Rafid013/4-Bit-PC/README.md

# 4 Bit PC Simulator for CSE404: Digital System Design Sessional
1. Created a 4 Bit PC Simulator using Proteus.
2. For executing a program, we built a very simple compiler using Java, that takes a assembly code as input and generates the machine code for our simulator as output.

Report: [https://github.com/Rafid013/4-Bit-PC/blob/master/cse-404-report.pdf](https://github.com/Rafid013/4-Bit-PC/blob/master/cse-404-report.pdf)
