Rafid013/4-Bit-PC/Diagrams/Timing Diagram/Images/ADC_address.jpg

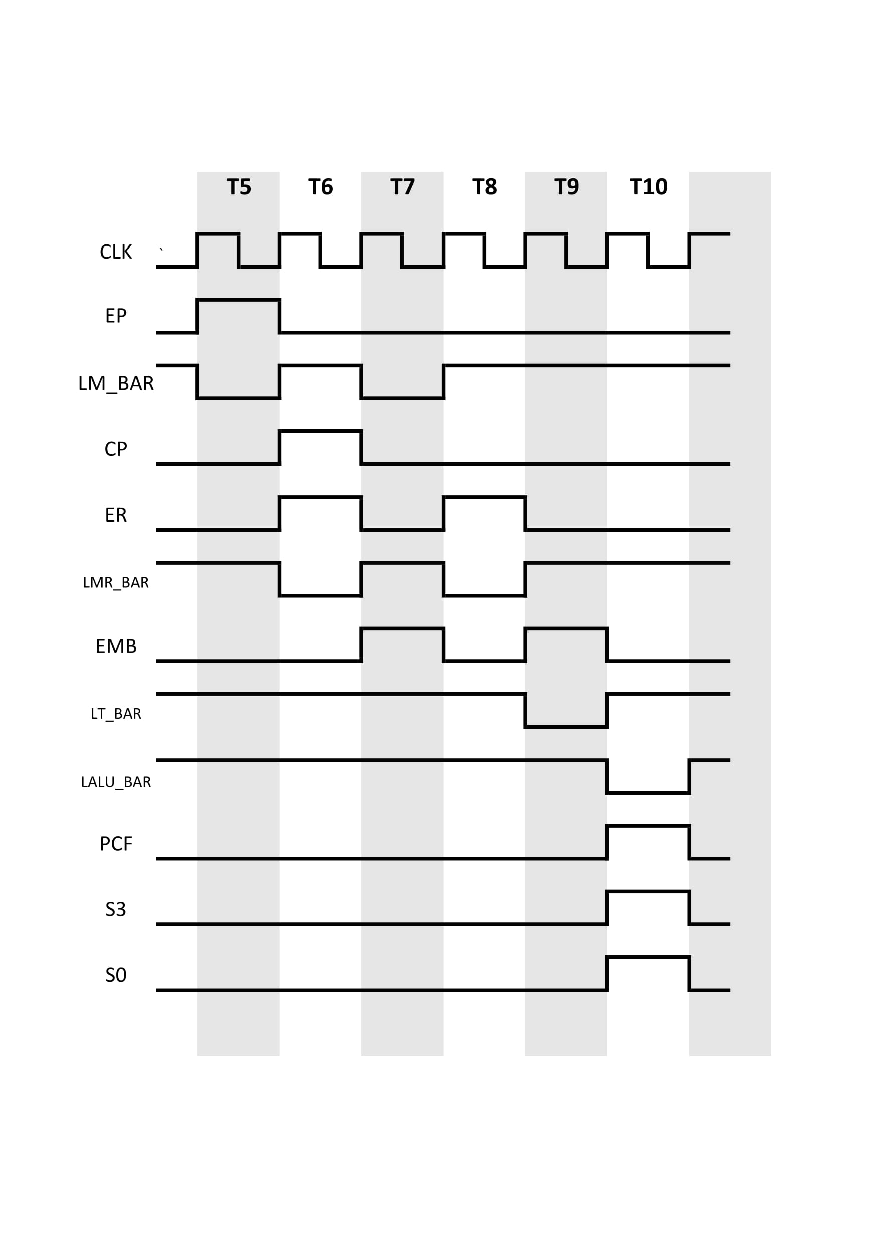
Diagrams/Timing Diagram/Images/ADC_address.jpg
