Rafid013/4-Bit-PC/Diagrams/Timing Diagram/Images/FETCH.jpg

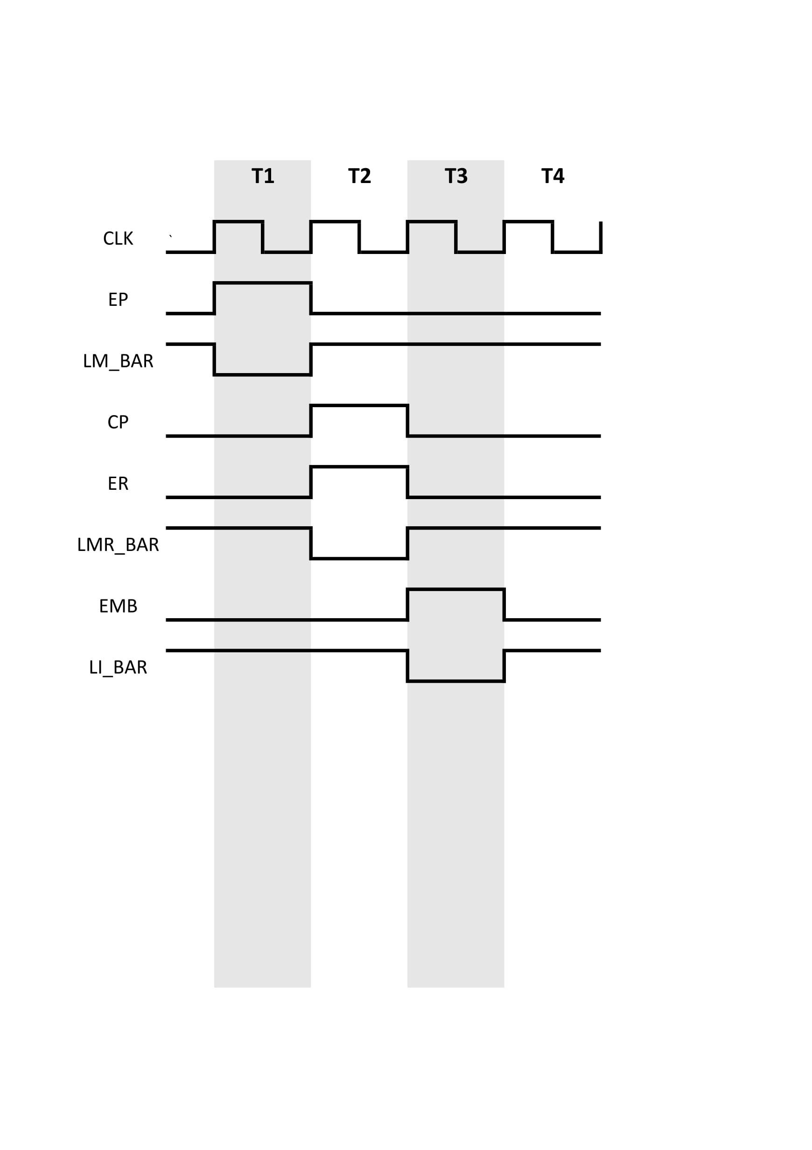
Diagrams/Timing Diagram/Images/FETCH.jpg
