Rafid013/4-Bit-PC/Diagrams/Timing Diagram/Images/OR_immediate.jpg

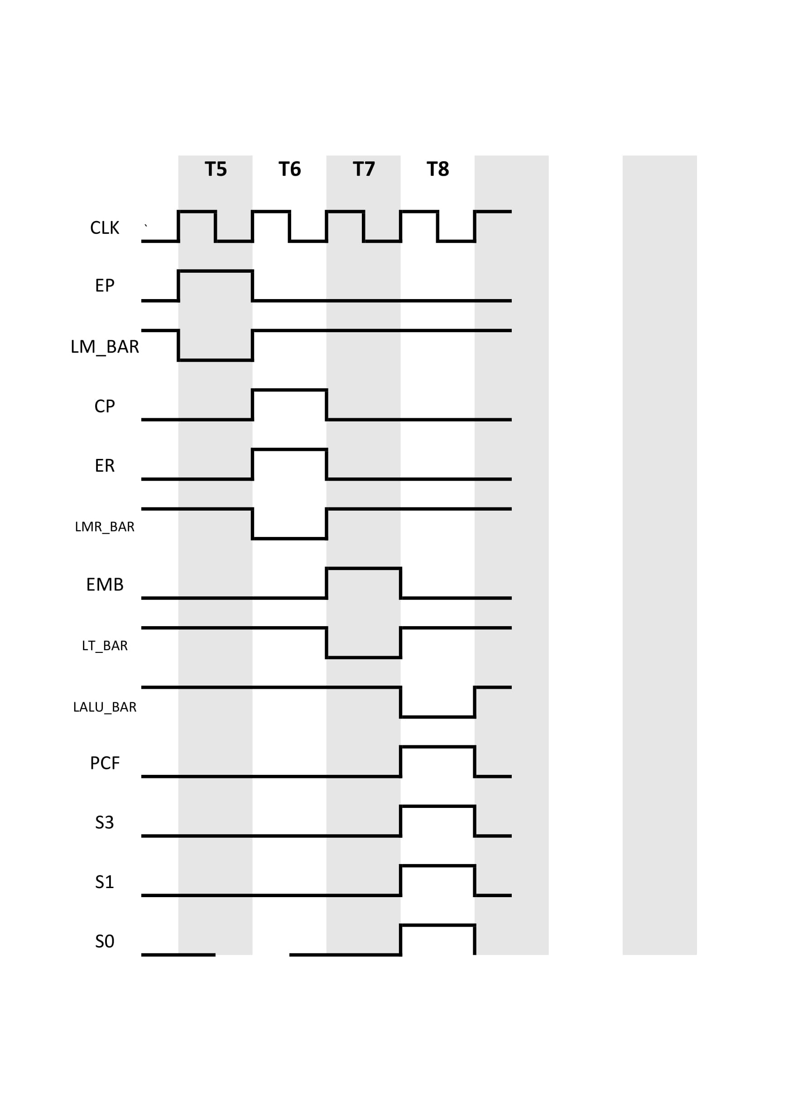
Diagrams/Timing Diagram/Images/OR_immediate.jpg
