Rafid013/4-Bit-PC/Diagrams/Timing Diagram/Images/PUSH.jpg

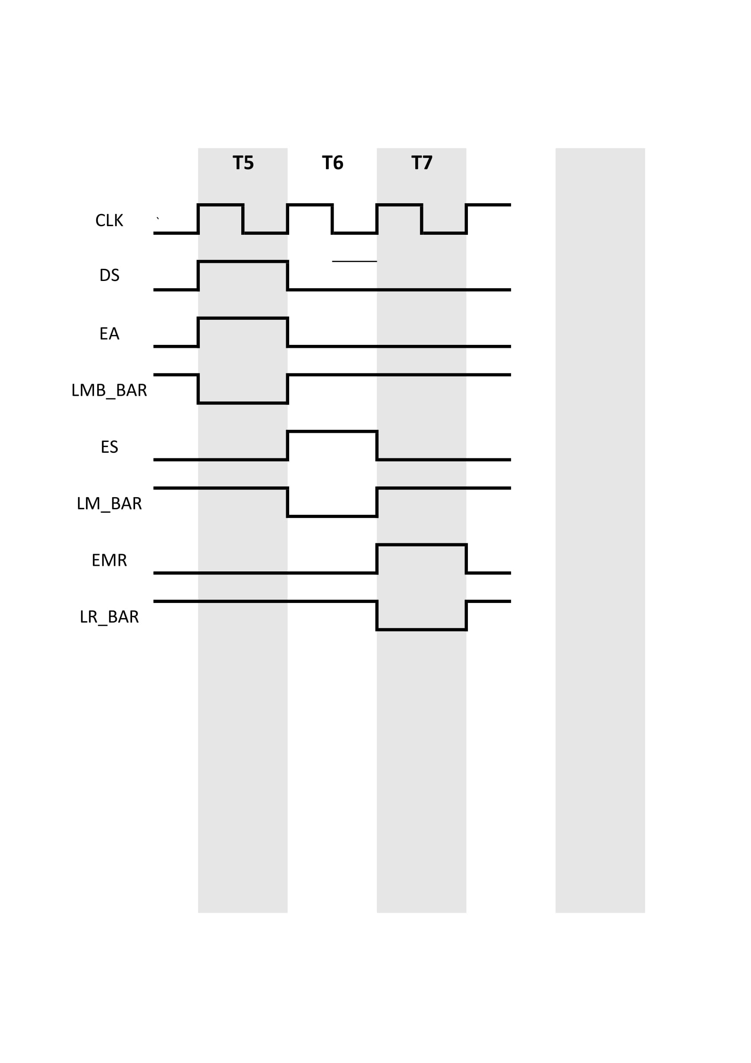
Diagrams/Timing Diagram/Images/PUSH.jpg
