Rafid013/4-Bit-PC/Simulation/4-bit PC Instructions.txt

04 LDA address;
09 STA address;
0E MOV B, Acc;
0F MOV Acc, Immediate;
12 ADC B;
14 ADC address;
1A SBB address;
20 OUT;
21 PUSH;
24 POP;
27 AND B;
29 OR address;
2F OR Immediate;
33 NOT;
34 XCHG;
37 CMP B;
39 TEST B;
3B ROL;
3C RCL;
3E JMP address;
41 JNZ address;
43 CLC;
44 CLS;
45 HLT;
46 NOP;
