Rafid013/4-Bit-PC/Diagrams/Circuit Diagram/MDR.PDF

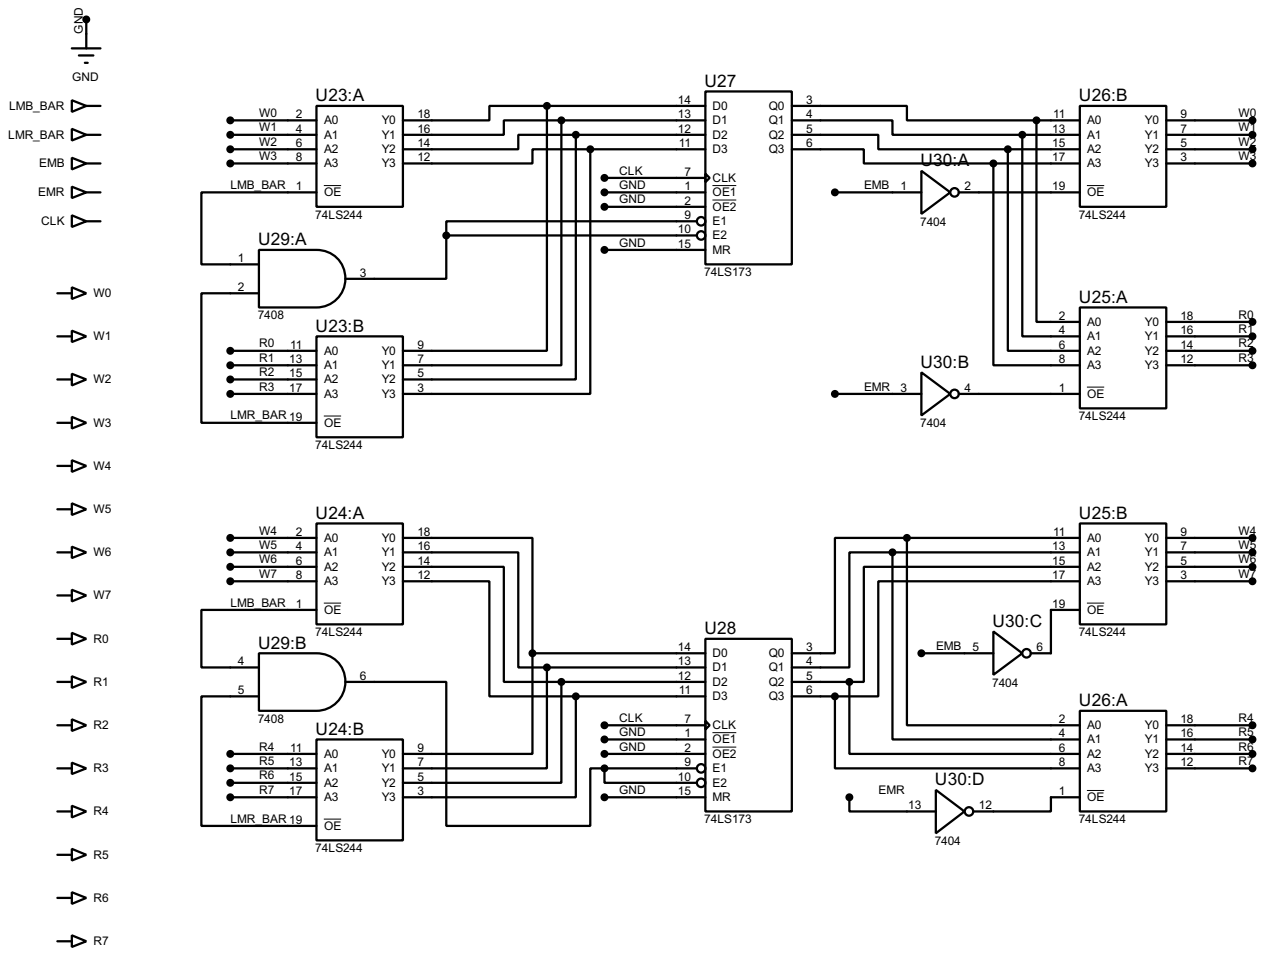
[picture p17: page 1]

GND R0R1R2R3 W4 W5 W6 W7 R4R5R6R7 CLK GND GND GND CLK GND GND GND W0 W1 W2 W3 R0R1R2R3 W4 W5 W6 W7 R4R5R6R7 LMB_BAR LMR_BAR LMB_BAR LMR_BAR EMB W0 W1 W2 W3 EMR EMB EMR LMB_BAR LMR_BAR EMB W0 W1 W2 W3 GNDW4 W5 W6 W7 R0R1R2R3R4R5R6R7 EMR CLK A0 2 A1 4 A2 6 A3 8 OE 1 Y0 18 Y1 16 Y2 14 Y3 12 U23:A 74LS244 A0 11 A1 13 A2 15 A3 17 OE 19 Y0 9 Y1 7 Y2 5 Y3 3 U23:B 74LS244 A0 2 A1 4 A2 6 A3 8 OE 1 Y0 18 Y1 16 Y2 14 Y3 12 U24:A 74LS244 A0 11 A1 13 A2 15 A3 17 OE 19 Y0 9 Y1 7 Y2 5 Y3 3 U24:B 74LS244 A0 2 A1 4 A2 6 A3 8 OE 1 Y0 18 Y1 16 Y2 14 Y3 12 U25:A 74LS244 A0 11 A1 13 A2 15 A3 17 OE 19 Y0 9 Y1 7 Y2 5 Y3 3 U25:B 74LS244 A0 2 A1 4 A2 6 A3 8 OE 1 Y0 18 Y1 16 Y2 14 Y3 12 U26:A 74LS244 D0 14 Q0 3 D1 13 Q1 4 D2 12 Q2 5 D3 11 Q3 6 CLK 7 OE1 1 OE2 2 E1 9 E2 10 MR 15 U27 74LS173 D0 14 Q0 3 D1 13 Q1 4 D2 12 Q2 5 D3 11 Q3 6 CLK 7 OE1 1 OE2 2 E1 9 E2 10 MR 15 U28 74LS173 12 3 U29:A 7408 45 6 U29:B 7408 1 2 U30:A 7404 A0 11 A1 13 A2 15 A3 17 OE 19 Y0 9 Y1 7 Y2 5 Y3 3 U26:B 74LS244 3 4 U30:B 7404 5 6 U30:C 7404 13 12 U30:D 7404
