Rafid013/4-Bit-PC/Diagrams/Circuit Diagram/All Circuit DIagrams.PDF

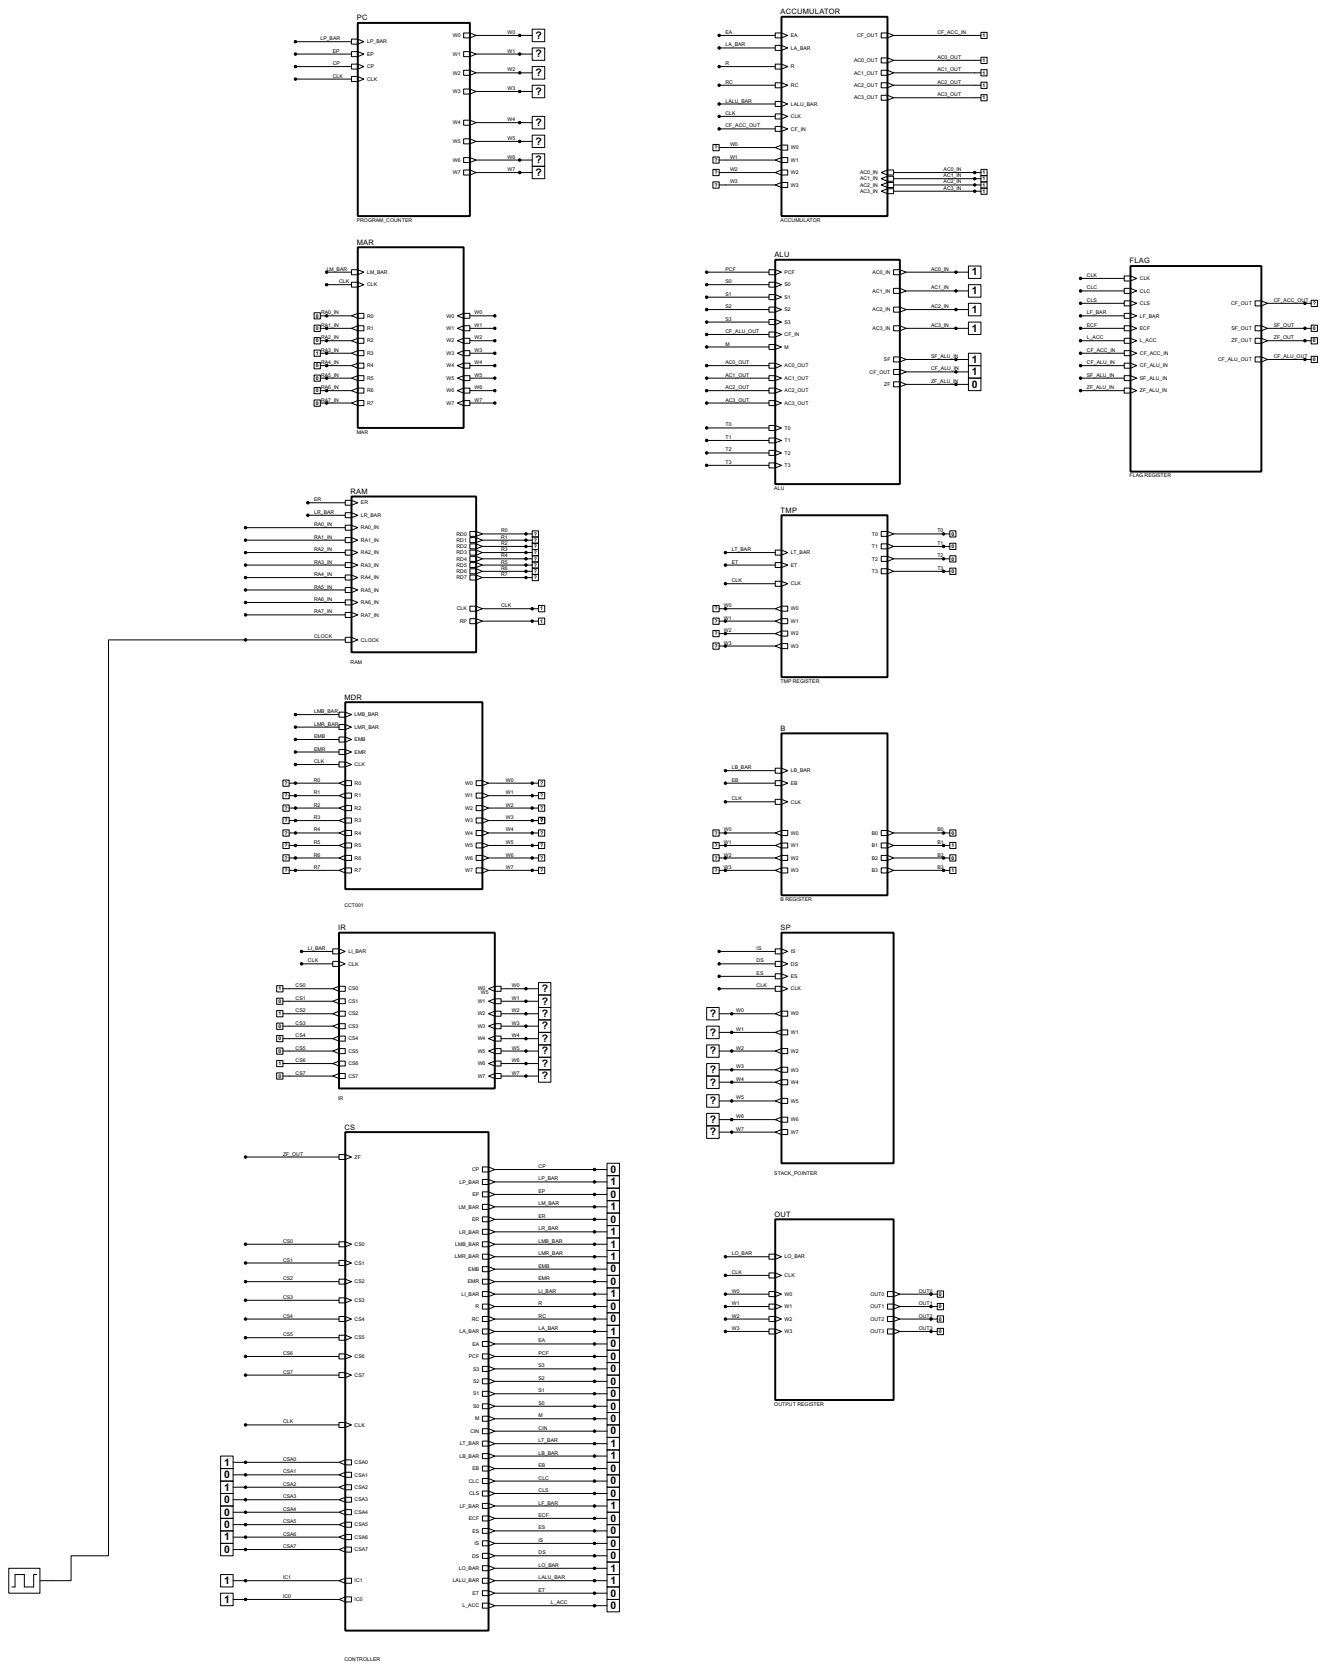
[picture p18: page 1]

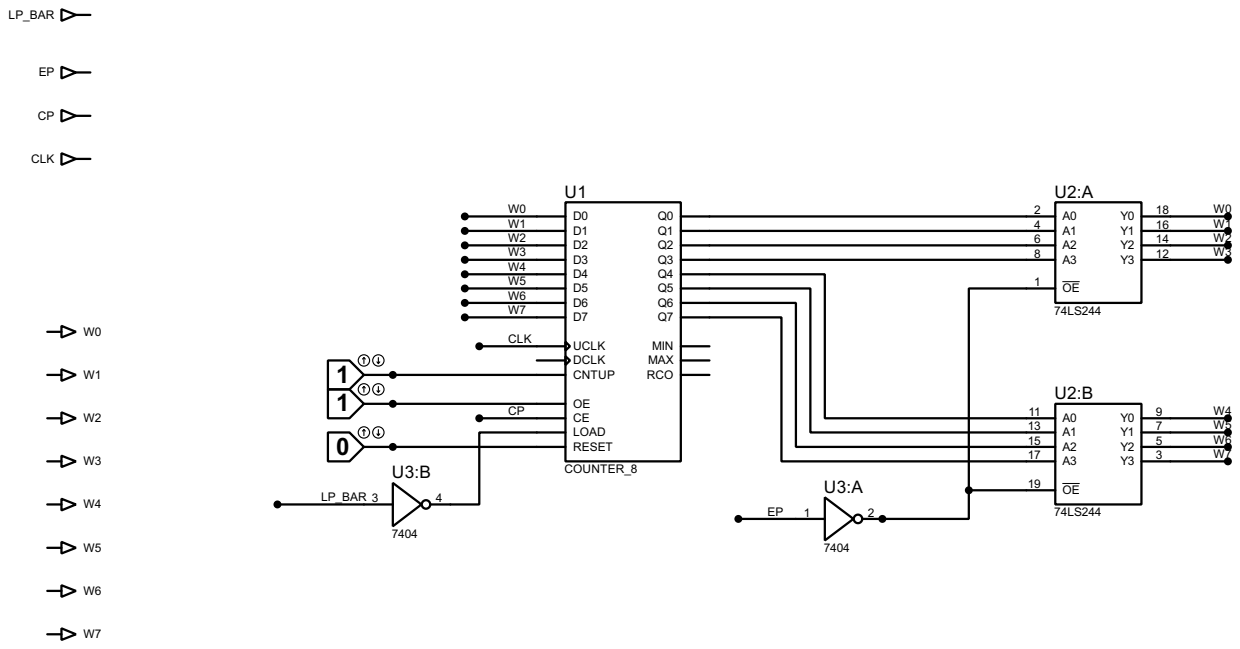
[picture p19: page 2]

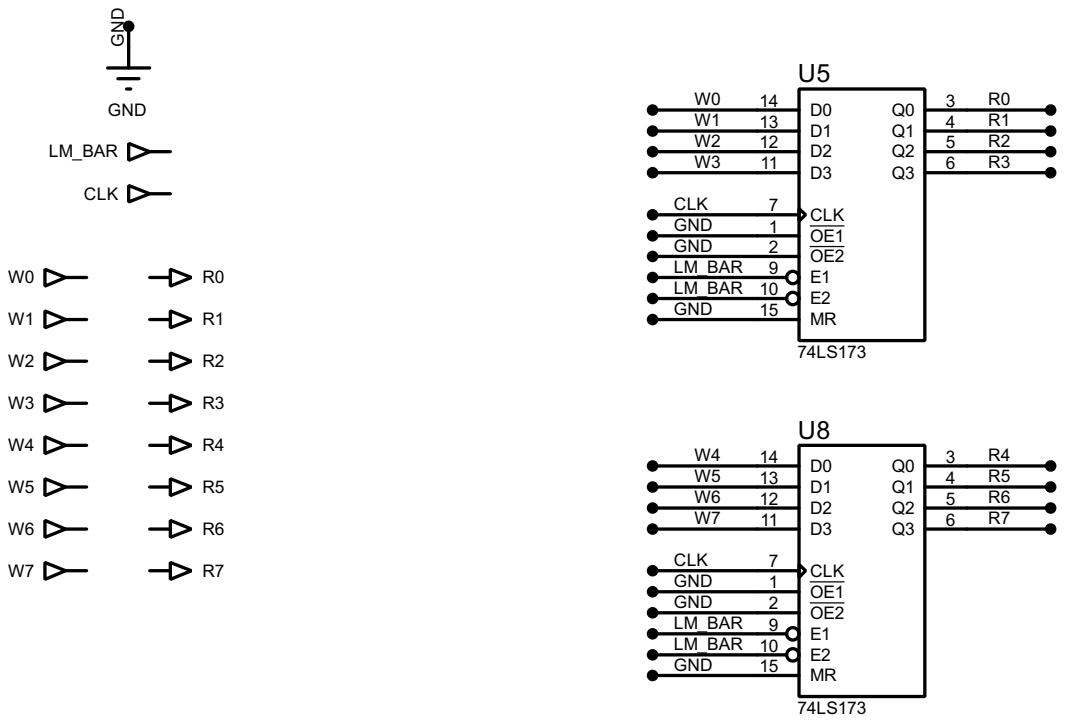
[picture p20: page 3]

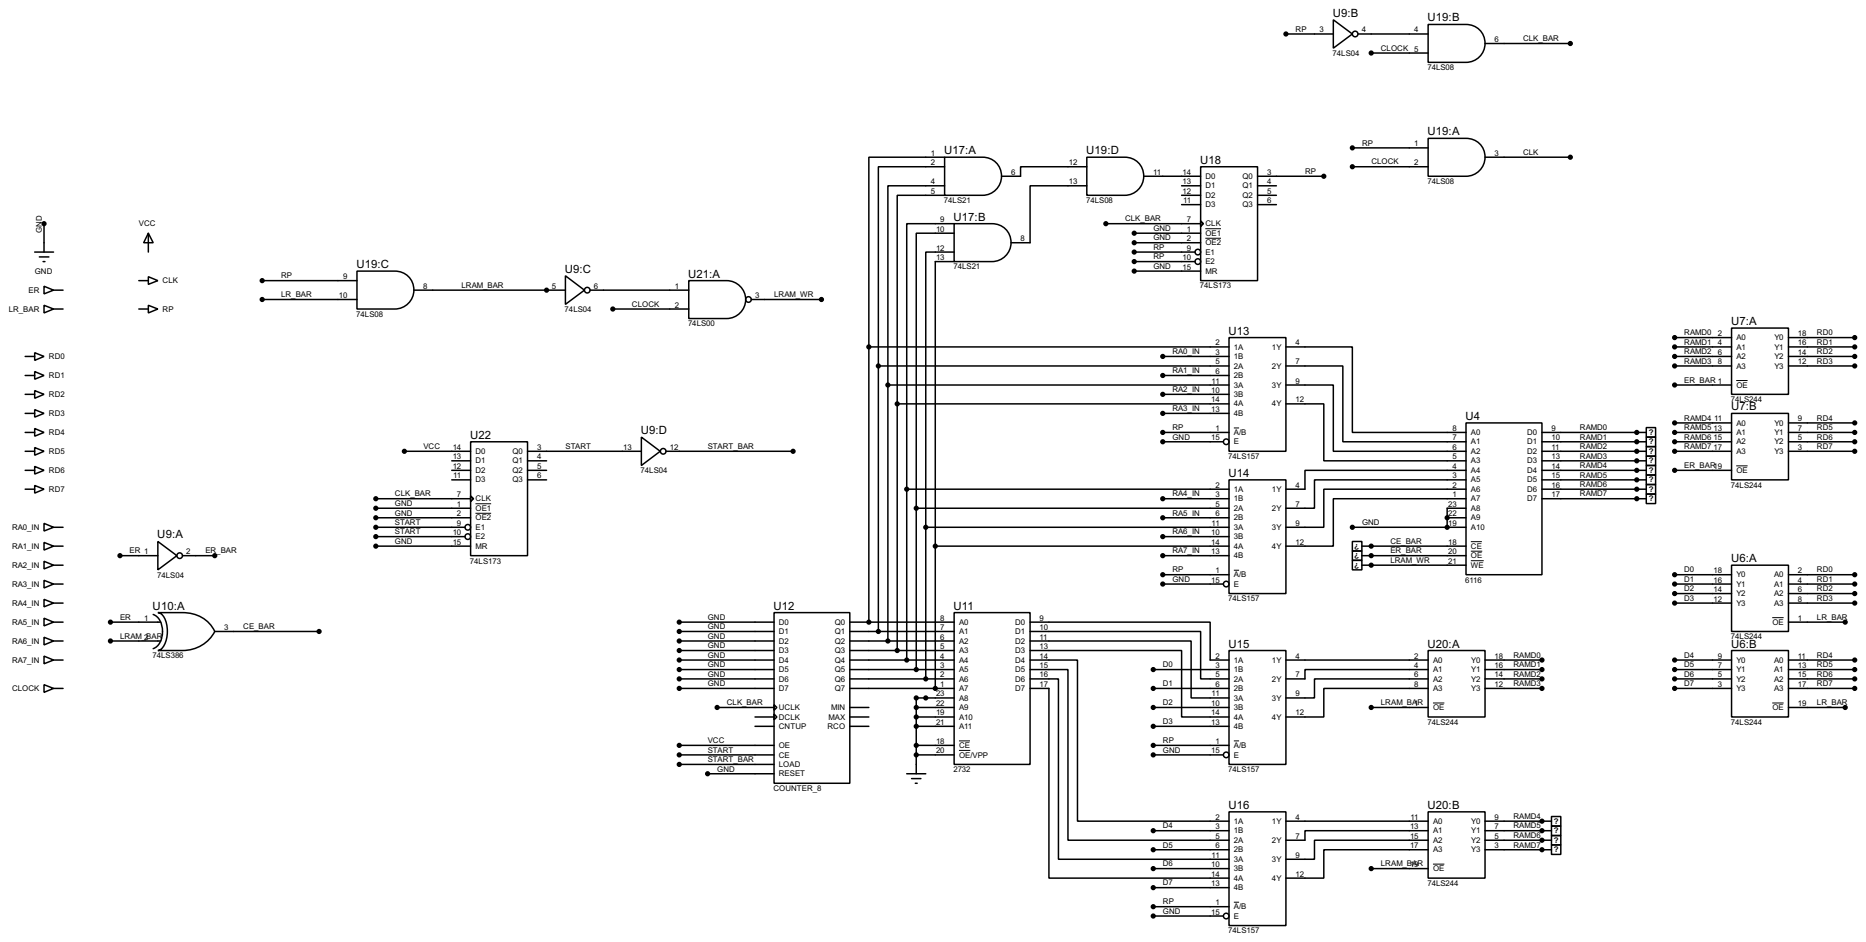
[picture p21: page 4]

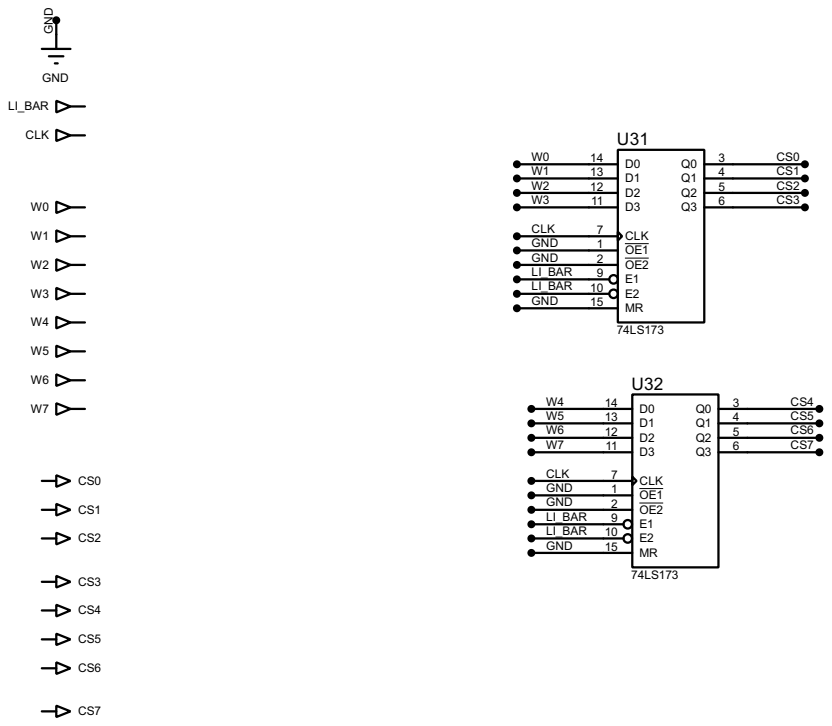
[picture p22: page 5]

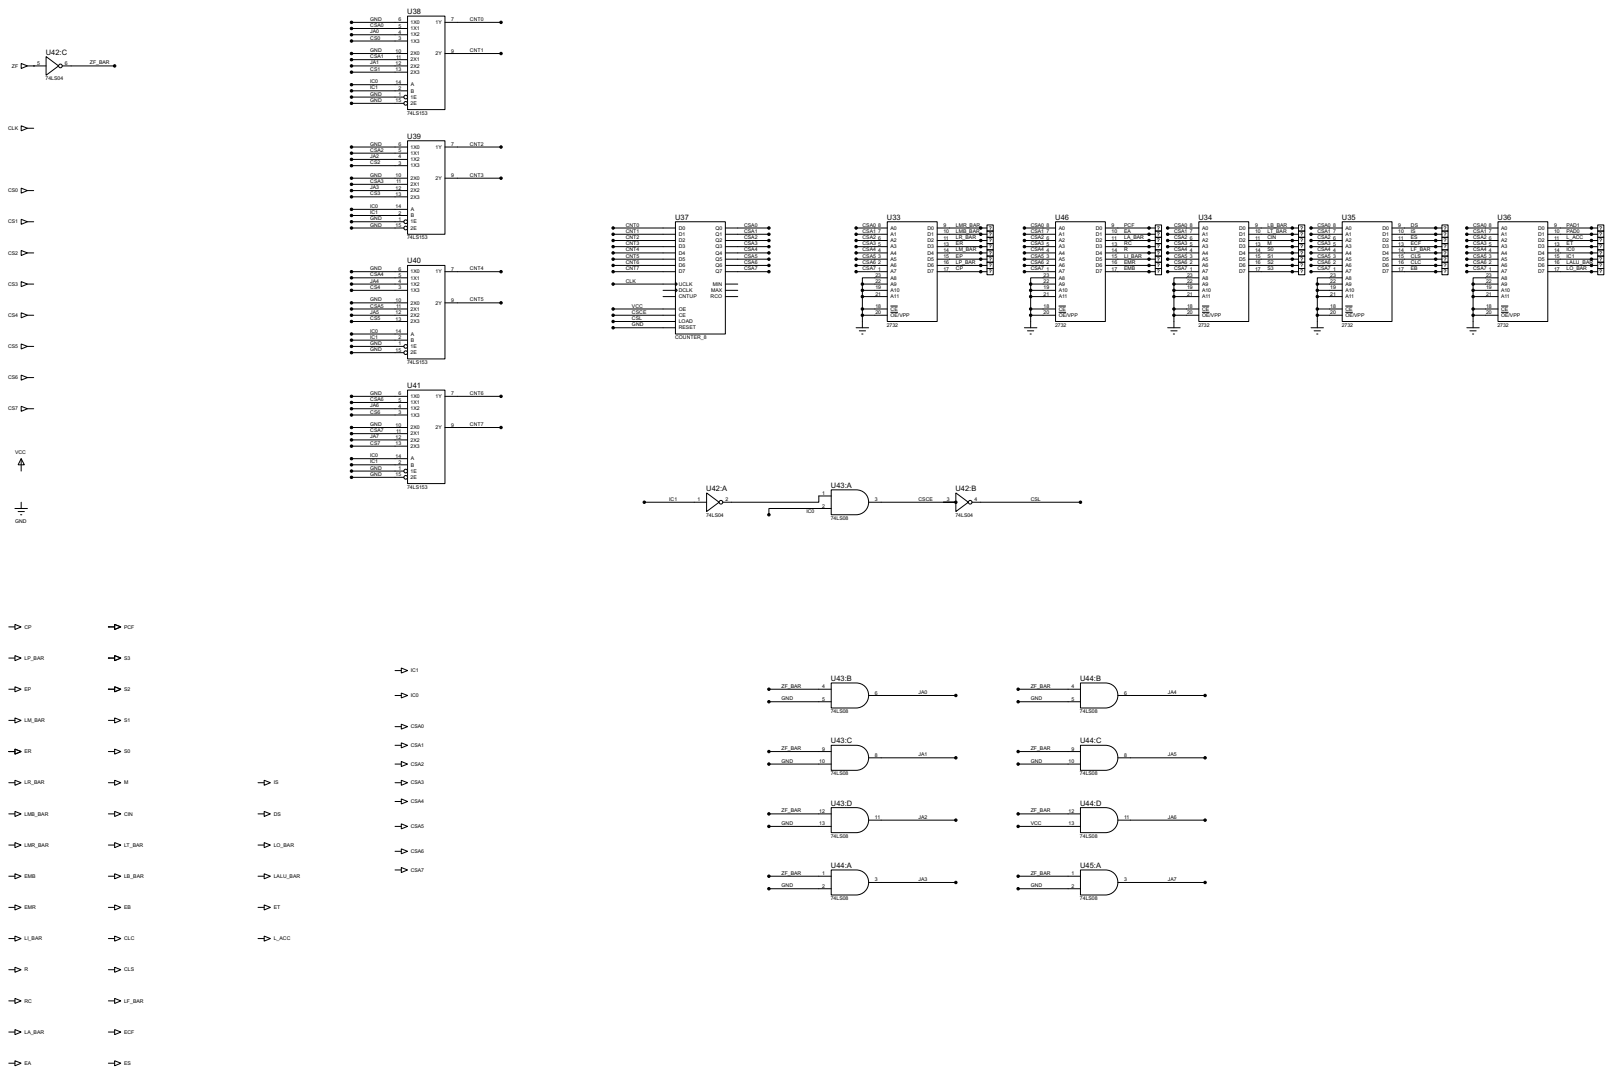
[picture p23: page 6]


GND D0D1 GND GND S1S2 D2D3 GND GND S1S2 LALU_BAR LALU LA_BAR LA RRC R + RC R + RC R + RC LA S2S1 LALU CLK GND GND GND GND GND Q0 AC0_IN W0 IQ1 AC1_IN W1 Q0 Q2 AC2_IN W2 Q1 Q3 AC3_IN W3 Q2 Q3 RCCF_IN I R Q3 RC AC0_OUT AC1_OUT AC2_OUT AC3_OUT GND W0 W1 W2 W3 EA Q0 Q1 Q2 Q3 CLK CF_OUT GND RCCF_IN LALU_BAR LA_BAR CLK GND EARRC W0 W1 W2 W3 AC0_OUT AC1_OUT AC2_OUT AC3_OUT CF_OUT D0 14 Q0 3 D1 13 Q1 4 D2 12 Q2 5 D3 11 Q3 6 CLK 7 OE1 1 OE2 2 E1 9 E2 10 MR 15 U47 74LS173 1X0 6 1Y 7 1X1 5 1X2 4 1X3 3 2X0 10 2Y 9 2X1 11 2X2 12 2X3 13 A 14 B 2 1E 1 2E 15 U48 74LS153 1X0 6 1Y 7 1X1 5 1X2 4 1X3 3 2X0 10 2Y 9 2X1 11 2X2 12 2X3 13 A 14 B 2 1E 1 2E 15 U49 74LS153 1 2 U50:A 74LS04 3 4 U50:B 74LS04 12 3 U51:A 74LS32 45 6 U51:B 74LS32 910 8 U51:C 74LS32 12 3 U52:A 74LS08 45 6 U52:B 74LS08 1213 11 U51:D 74LS32 910 8 U52:C 74LS08 12 3 U53:A 74LS32 A0 2 A1 4 A2 6 A3 8 OE 1 Y0 18 Y1 16 Y2 14 Y3 12 U54:A 74LS244 A0 11 A1 13 A2 15 A3 17 OE 19 Y0 9 Y1 7 Y2 5 Y3 3 U54:B 74LS244 5 6 U50:C 74LS04 D0 14 Q0 3 D1 13 Q1 4 D2 12 Q2 5 D3 11 Q3 6 CLK 7 OE1 1 OE2 2 E1 9 E2 10 MR 15 U55 74LS173 13 12 U50:D 74LS04 1213 11 U52:D 74LS08 AC0_IN AC1_IN AC2_IN AC3_IN CF_IN

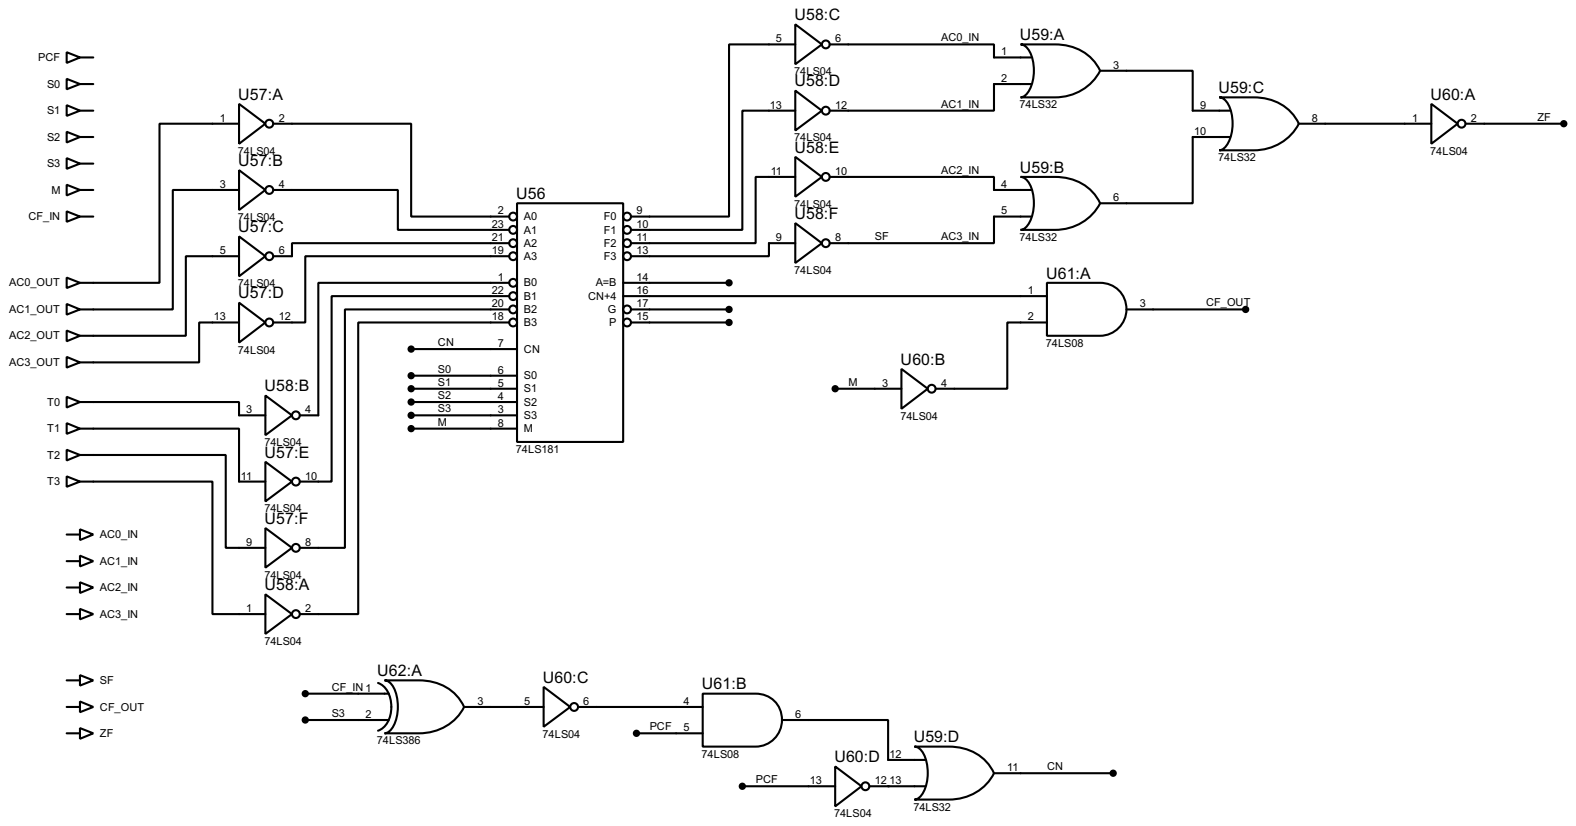
[picture p24: page 8]

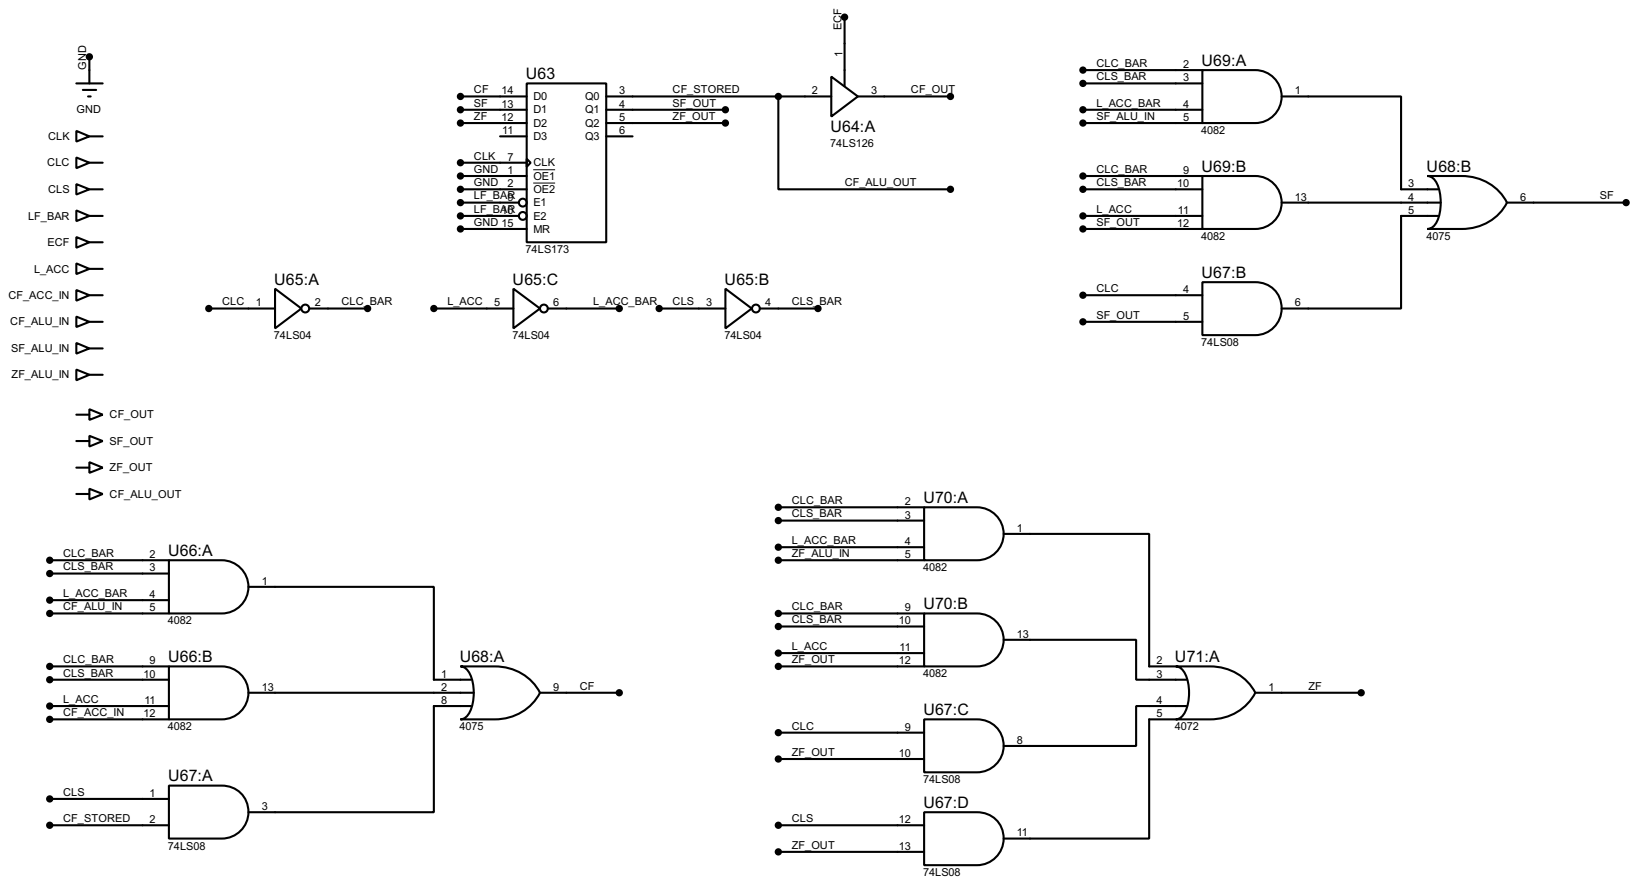
[picture p25: page 9]

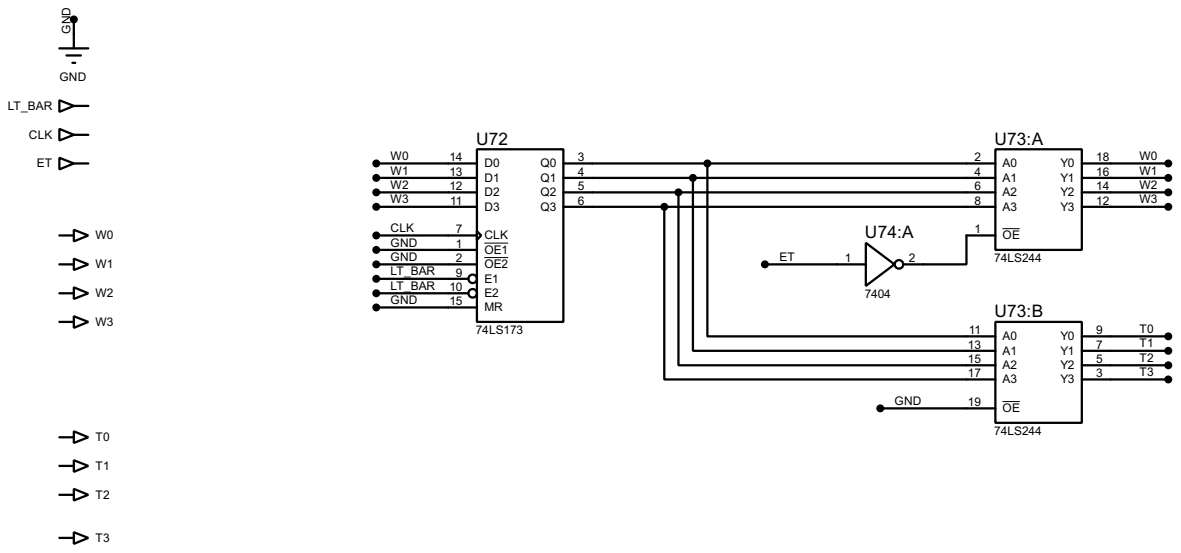
[picture p26: page 10]

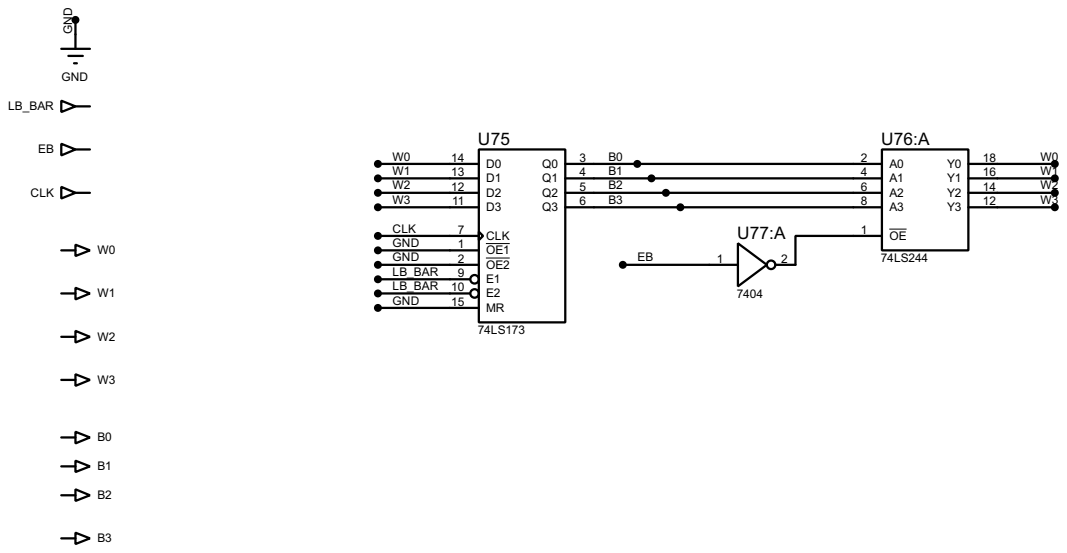
[picture p27: page 11]

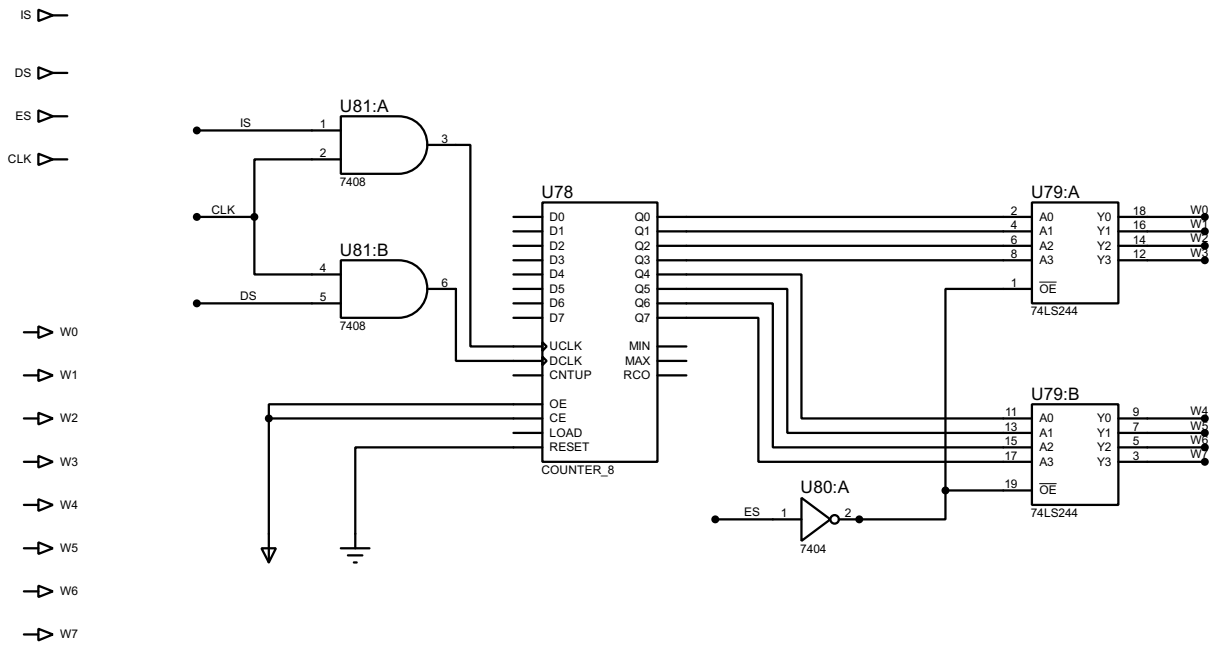
[picture p28: page 12]

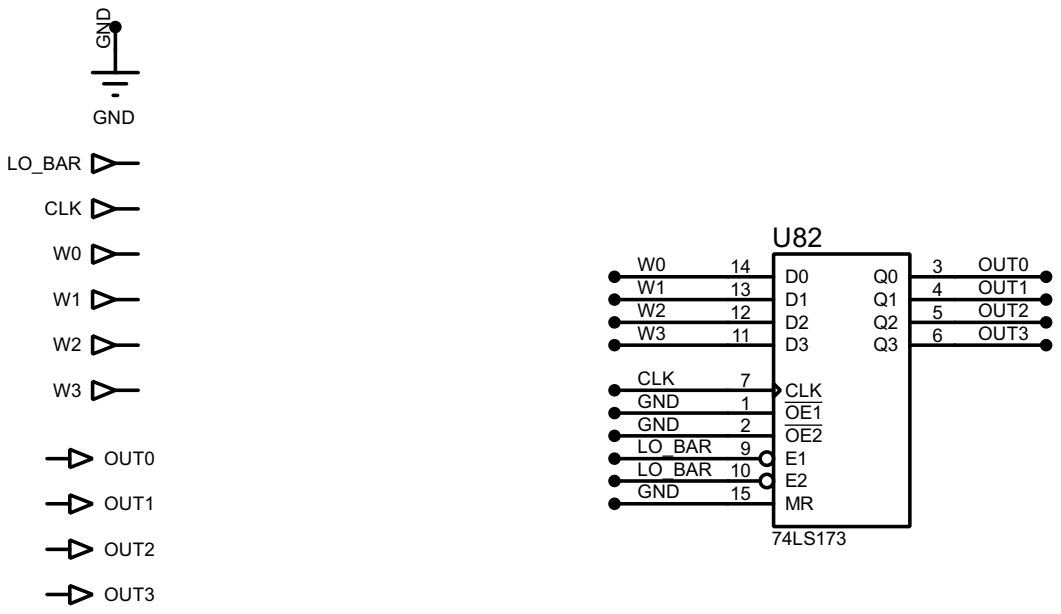
[picture p29: page 13]


GND R0R1R2R3 W4 W5 W6 W7 R4R5R6R7 CLK GND GND GND CLK GND GND GND W0 W1 W2 W3 R0R1R2R3 W4 W5 W6 W7 R4R5R6R7 LMB_BAR LMR_BAR LMB_BAR LMR_BAR EMB W0 W1 W2 W3 EMR EMB EMR LMB_BAR LMR_BAR EMB W0 W1 W2 W3 GNDW4 W5 W6 W7 R0R1R2R3R4R5R6R7 EMR CLK A0 2 A1 4 A2 6 A3 8 OE 1 Y0 18 Y1 16 Y2 14 Y3 12 U23:A 74LS244 A0 11 A1 13 A2 15 A3 17 OE 19 Y0 9 Y1 7 Y2 5 Y3 3 U23:B 74LS244 A0 2 A1 4 A2 6 A3 8 OE 1 Y0 18 Y1 16 Y2 14 Y3 12 U24:A 74LS244 A0 11 A1 13 A2 15 A3 17 OE 19 Y0 9 Y1 7 Y2 5 Y3 3 U24:B 74LS244 A0 2 A1 4 A2 6 A3 8 OE 1 Y0 18 Y1 16 Y2 14 Y3 12 U25:A 74LS244 A0 11 A1 13 A2 15 A3 17 OE 19 Y0 9 Y1 7 Y2 5 Y3 3 U25:B 74LS244 A0 2 A1 4 A2 6 A3 8 OE 1 Y0 18 Y1 16 Y2 14 Y3 12 U26:A 74LS244 D0 14 Q0 3 D1 13 Q1 4 D2 12 Q2 5 D3 11 Q3 6 CLK 7 OE1 1 OE2 2 E1 9 E2 10 MR 15 U27 74LS173 D0 14 Q0 3 D1 13 Q1 4 D2 12 Q2 5 D3 11 Q3 6 CLK 7 OE1 1 OE2 2 E1 9 E2 10 MR 15 U28 74LS173 12 3 U29:A 7408 45 6 U29:B 7408 1 2 U30:A 7404 A0 11 A1 13 A2 15 A3 17 OE 19 Y0 9 Y1 7 Y2 5 Y3 3 U26:B 74LS244 3 4 U30:B 7404 5 6 U30:C 7404 13 12 U30:D 7404
