Rafid013/4-Bit-PC/Simulation/Final.PDF

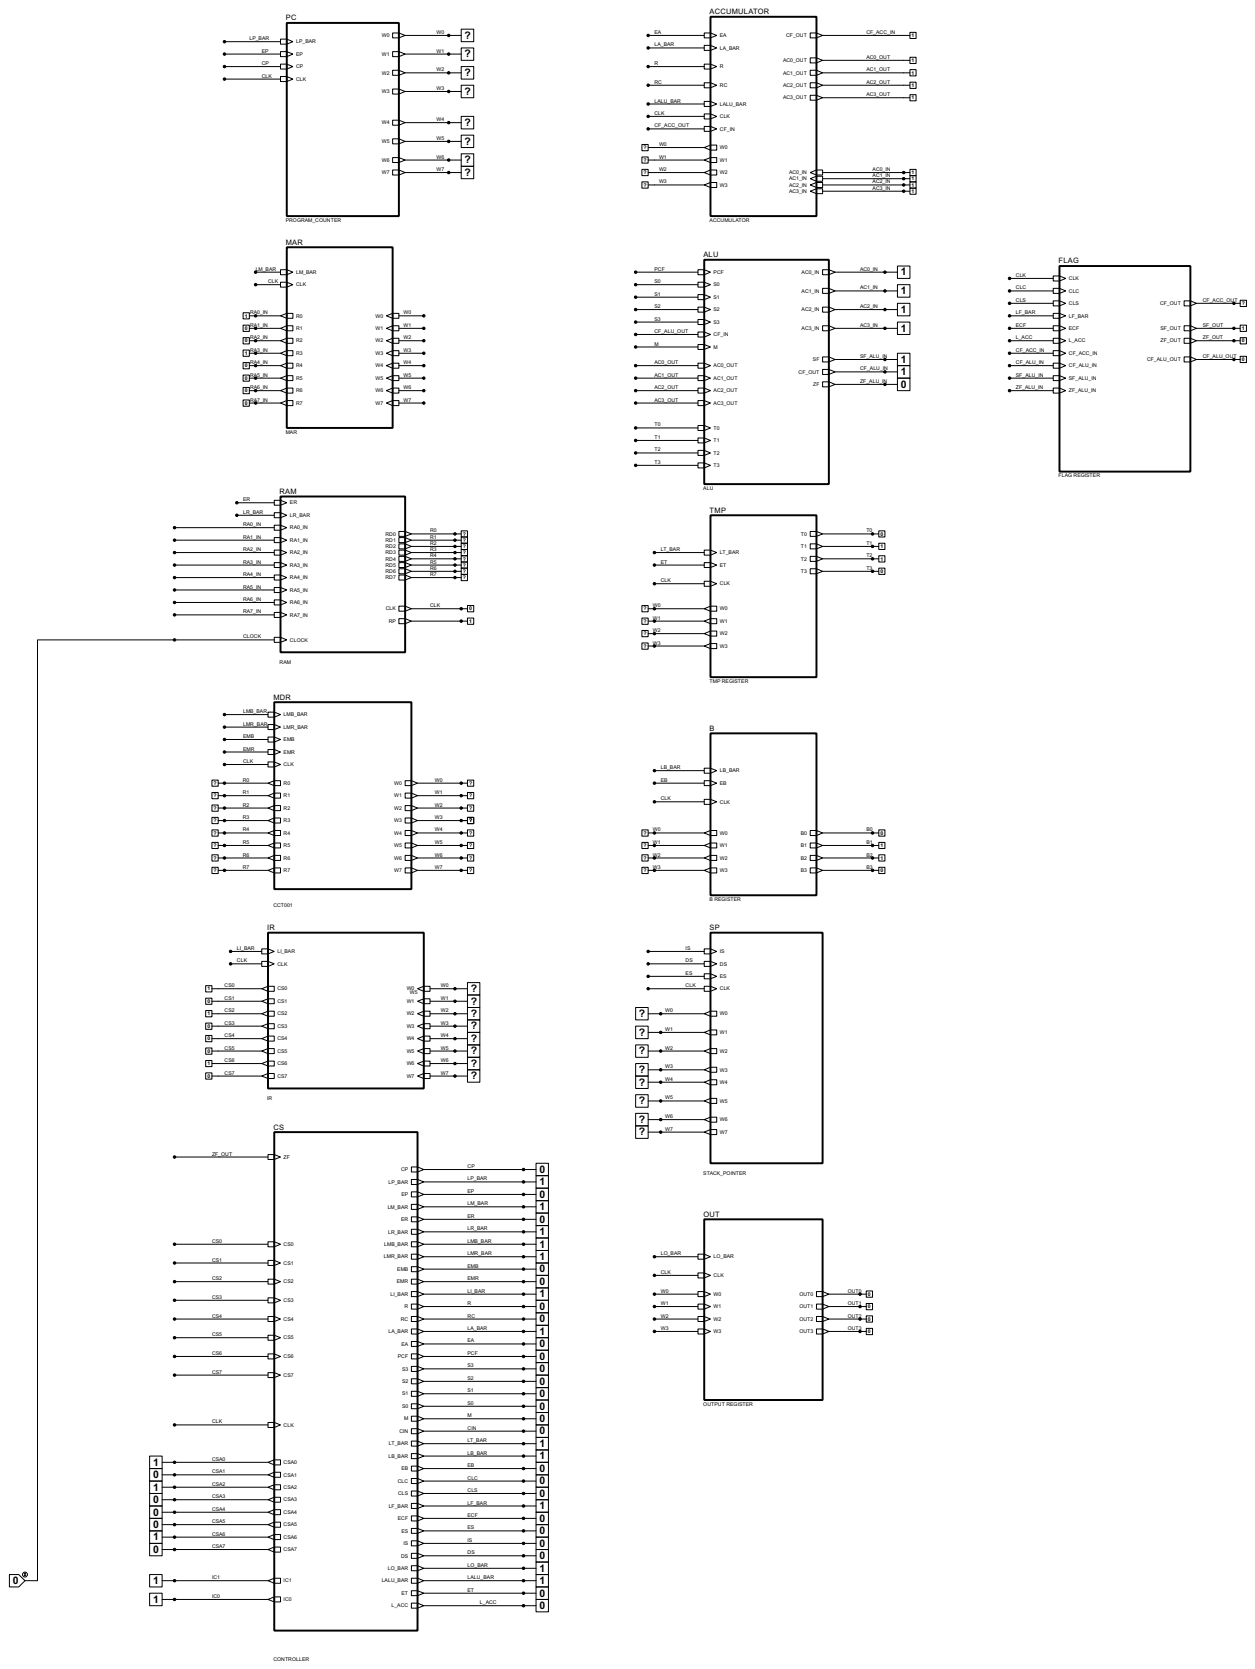
[picture p30: page 1]
