Rafid013/4-Bit-PC/Diagrams/Block Diagram/Block_Diagram.pdf

PC

8 | ACC

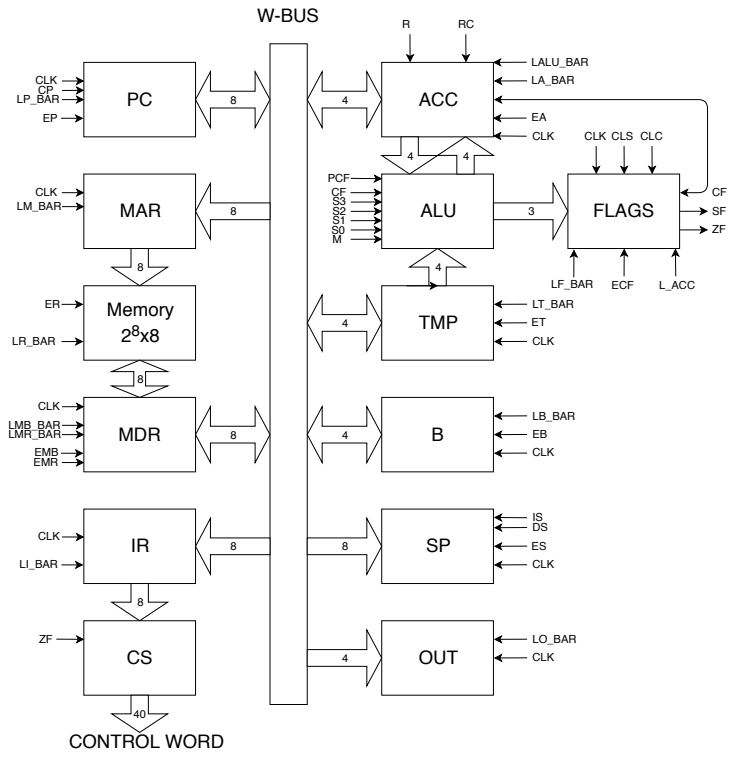
[picture p31: page 1]
MAR; Memory 2; MDR; ALU; TMP; OUT; CONTROL WORD; FLAGS; W-BUS; CLK CP LP_BAR; CLK LM_BAR; LR_BAR; CLK; LMB_BAR LMR_BAR; EMB EMR; LI_BAR; LO_BAR; LB_BAR; LT_BAR; PCF CF S3 S2 S1 S0 M; LALU_BAR; LA_BAR; CLK CLS CLC; LF_BAR; ECF; L_ACC
