Rafid013/4-Bit-PC/(list of files, drawings)

Other design files:
Simulation/4-bit PC.pdsprj
Simulation/Blocks/ACC.pdsprj
Simulation/Blocks/ALU.pdsprj
Simulation/Blocks/B_reg.pdsprj
Simulation/Blocks/CS.pdsprj
Simulation/Blocks/FLAG.pdsprj
Simulation/Blocks/IR.pdsprj
Simulation/Blocks/MAR.pdsprj
Simulation/Blocks/MDR.pdsprj
Simulation/Blocks/Out.pdsprj
Simulation/Blocks/PC.pdsprj
Simulation/Blocks/RAM.pdsprj
Simulation/Blocks/SP.pdsprj
Simulation/Blocks/Test.pdsprj
Simulation/Blocks/TMP.pdsprj
