Rafid013/4-Bit-PC/(commit log)

2018-07-23 Accumulator done
    [Accumulator.pdsprj]
2018-07-23 MAR and MDR done
    [MAR.pdsprj, MDR.pdsprj]
2018-07-24 PC and SP added
    [Accumulator.pdsprj, B_reg.pdsprj, IR.pdsprj, MAR.pdsprj, MDR.pdsprj, PC.pdsprj, SP.pdsprj, TMP.pdsprj]
2018-07-25 OUT added
    [Out.pdsprj]
2018-07-25 ALU added (not completed)
    [ALU.pdsprj, Out.pdsprj]
2018-07-25 TMP solved
    [TMP.pdsprj]
2018-07-26 Revert "MAR and MDR done"
    This reverts commit ff8a44da37d3b174e7f9d9688be005389c56027b.
    [MDR.pdsprj]
2018-07-26 Removing MAR and MDR
    [MAR.pdsprj, MDR.pdsprj]
2018-07-26 Updated MAR and MDR added
    Please check for errors.
    [MAR.pdsprj, MDR.pdsprj]
2018-07-26 ALU completed
    [ALU.pdsprj]
2018-07-26 RAM Completed and CS partially Completed
    [CS.pdsprj, RAM.pdsprj]
2018-07-27 CS updated
    [CS.pdsprj]
2018-07-27 RAM updated
    [RAM.pdsprj]
2018-07-27 CS completed
    [CS.pdsprj]
2018-07-27 RAM 0th address load problem solved
    [RAM.pdsprj]
2018-07-27 modified cs
    [CS.pdsprj]
2018-07-28 Project Completed
    [Final.pdsprj]
2018-07-30 Functions Tested
    Quality Control Passed
    [Final.pdsprj]
2018-07-30 Timing diagram added
    [ADC_address.xlsx, FETCH.xlsx, JMP.xlsx, OR_immediate.xlsx, PUSH.xlsx, XCHG.xlsx]
2018-07-31 Updated
    Updated according to teacher's requirement
    [Final.pdsprj]
2018-07-31 Final Commit
    [4-bit PC.pdsprj, ACC.pdsprj, ADC_address.xlsx, ALU.pdsprj, B_reg.pdsprj, CS.pdsprj, FETCH.xlsx, FLAG.pdsprj]
